pcremades/Pendulo_Interactivo/README.md

# Péndulo Interactivo
Se trata de un péndulo físico con un sistema de adquisición de datos que permite hacer demostraciones didácticas del comportamiento de un péndulo. Aplicable a la enseñanza de física de nivel medio y superior.
El sistema de adquisición de datos está contruido con sensores recuperados de un mouse de PC, de modo que se aprovecha el residuo electrónico.

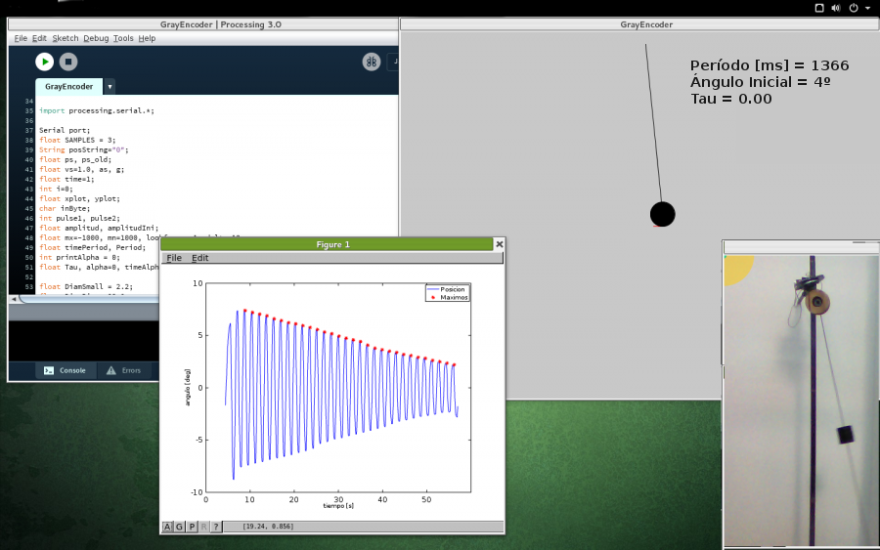
[picture p1: Imagenes/App.png]
Imagen Pendulo Intercativo


<br />Esta obra está bajo una <a rel="license" href="http://creativecommons.org/licenses/by-nc/4.0/">Licencia Creative Commons Atribución-NoComercial 4.0 Internacional</a>.
