pcremades/Pendulo_Interactivo/Imagenes/Completo.JPG

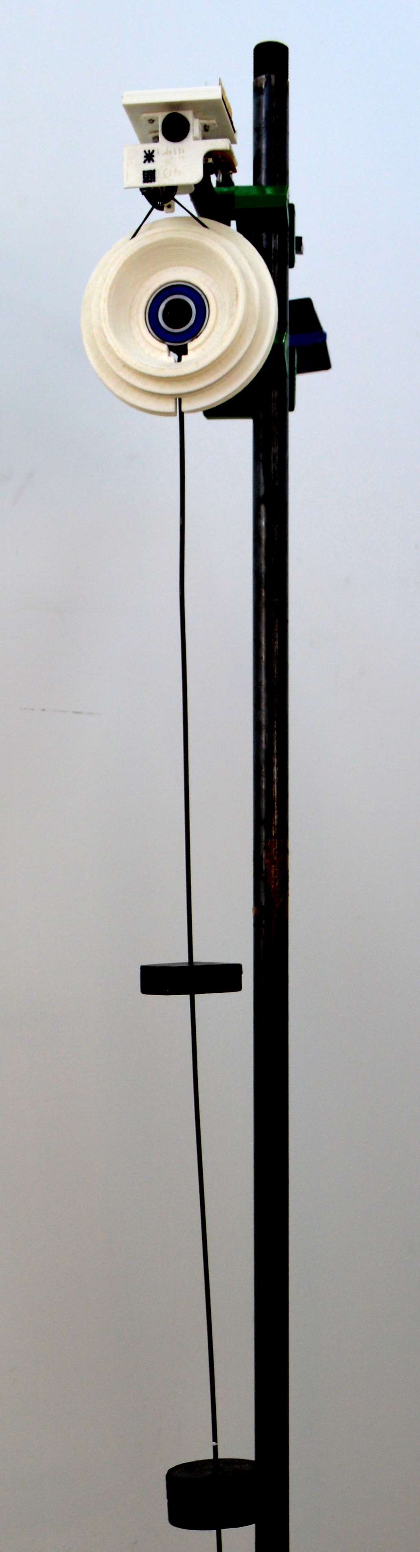
Imagenes/Completo.JPG
