pcremades/Pendulo_Interactivo/Imagenes/pendulo UTN1.jpg

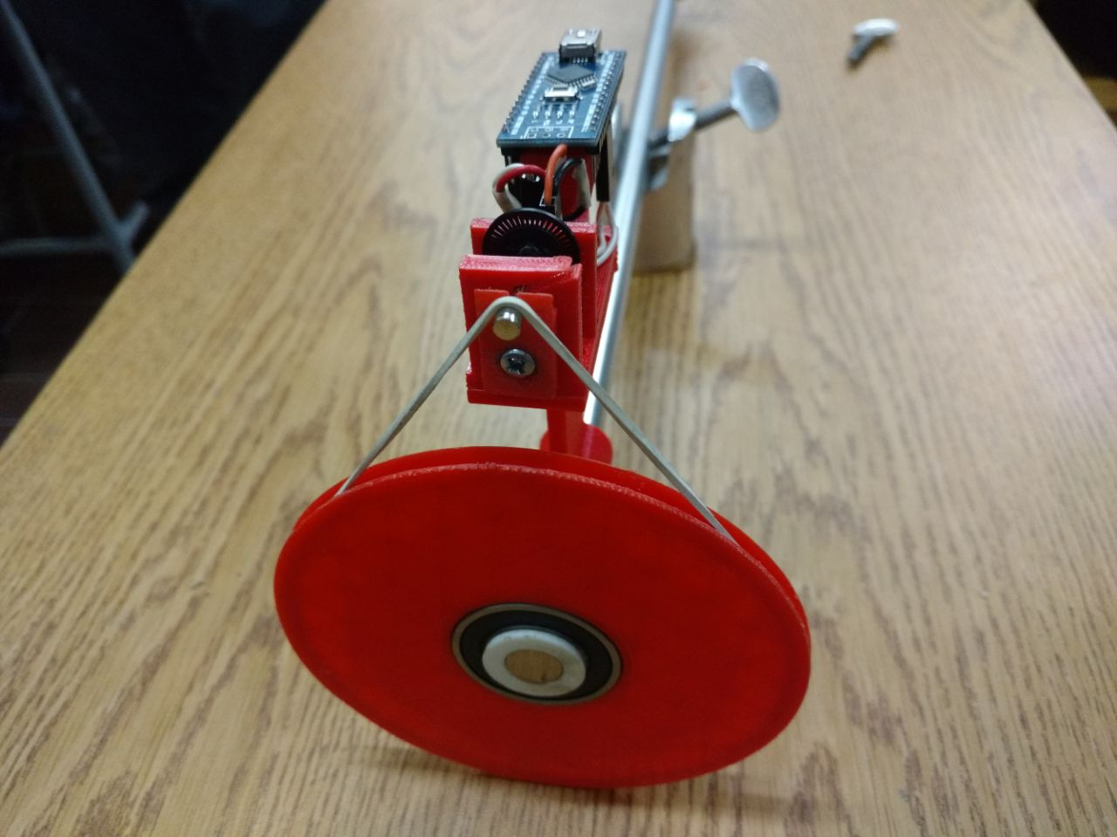
Imagenes/pendulo UTN1.jpg
