pcremades/Pendulo_Interactivo/Imagenes/pendulo UTN2.jpg

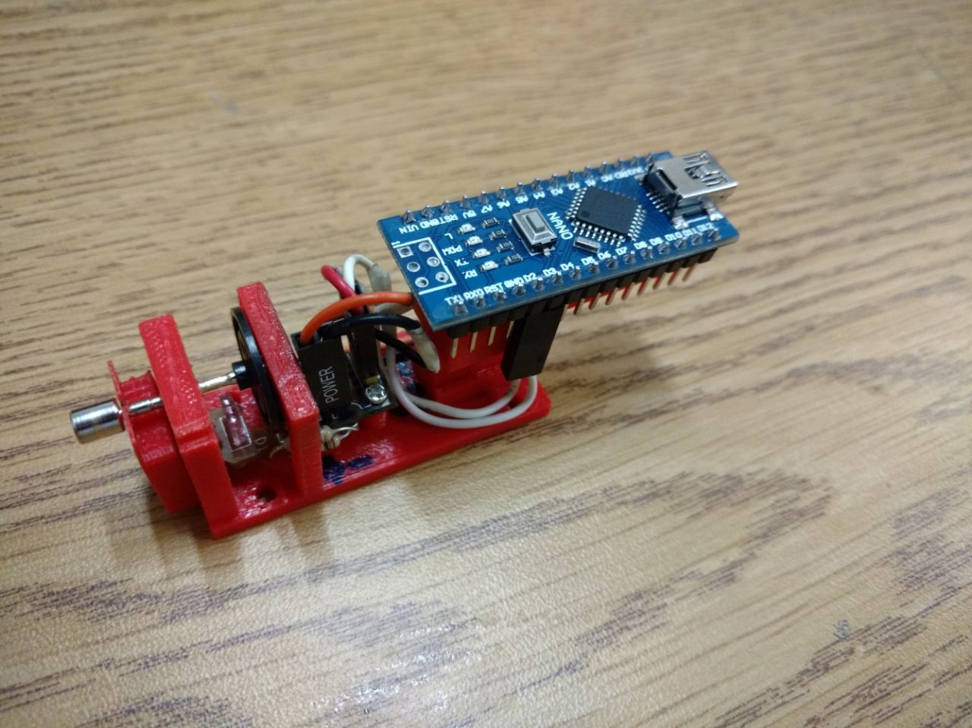
Imagenes/pendulo UTN2.jpg
