pcremades/Pendulo_Interactivo/Imagenes/pendulo UTN3.jpg

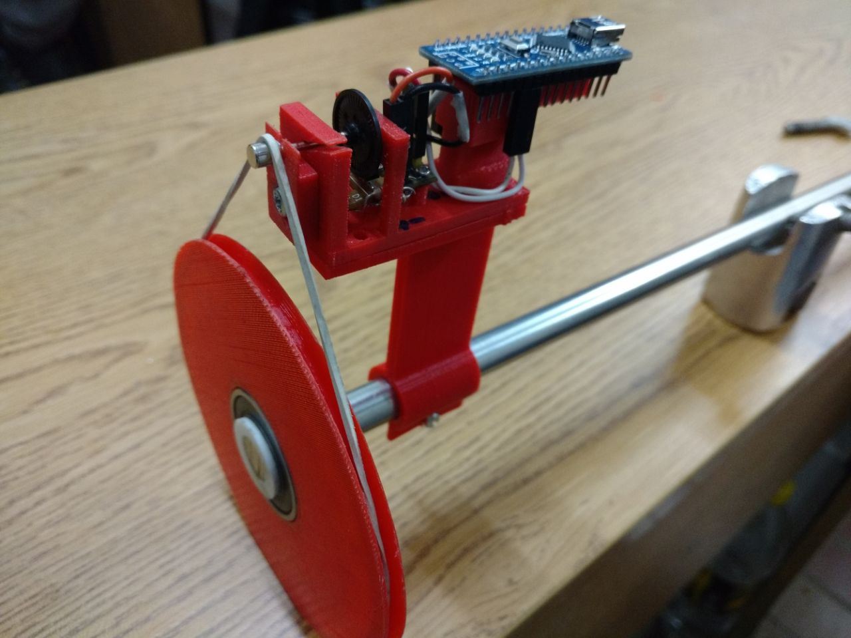
Imagenes/pendulo UTN3.jpg
