pcremades/Pendulo_Interactivo/(commit log)

2018-04-04 Reorganizo el repositorio para que tenga la misma estructura que Riel_de_Aire
2018-04-04 Update README.md
    Cambio path a la Imagen ('blob' por 'raw') para que renderice bien en OSF
2018-04-04 Cambio los códigos que envía en Arduino (1 y 2) por '+' y '-' para indicar sentido de movimiento
