pcremades/Pendulo_Interactivo/(notices)

Notices in the files:
Software/Pendulo/Pendulo.pde:
Copyright 2015 Pablo Cremades
This program is free software: you can redistribute it and/or modify
it under the terms of the GNU General Public License as published by
the Free Software Foundation, either version 3 of the License, or
(at your option) any later version.
